can-ozcan/Setup-for-Testing-Optical-Chips/Setup 2/Setup 2.jpg

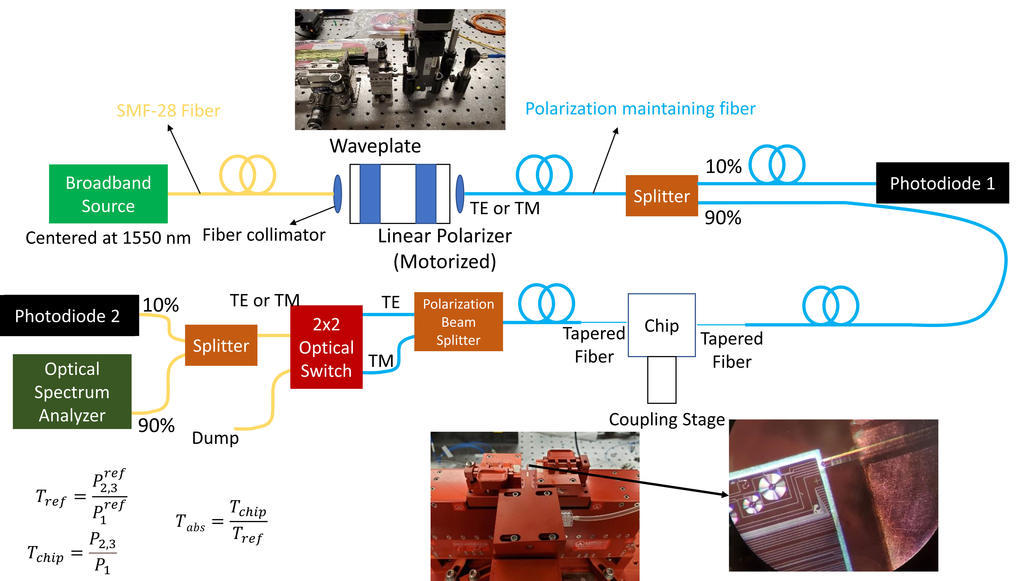
Setup 2/Setup 2.jpg
