can-ozcan/Setup-for-Testing-Optical-Chips/Setup 1/Setup 1.jpg

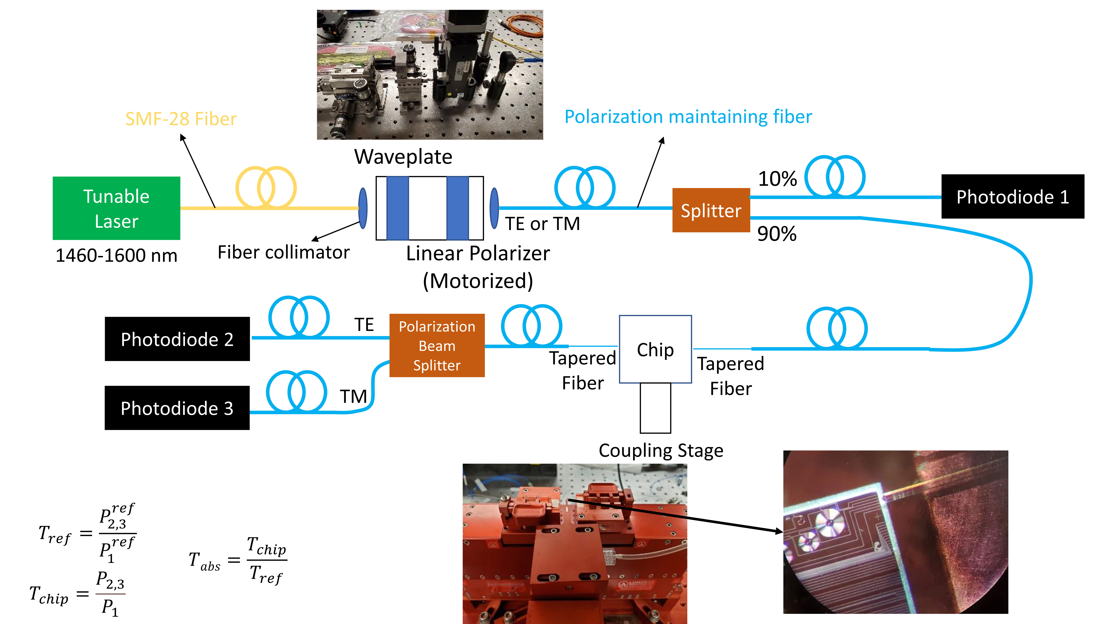
Setup 1/Setup 1.jpg
