can-ozcan/Setup-for-Testing-Optical-Chips/Setup 1/Misalignment.jpg

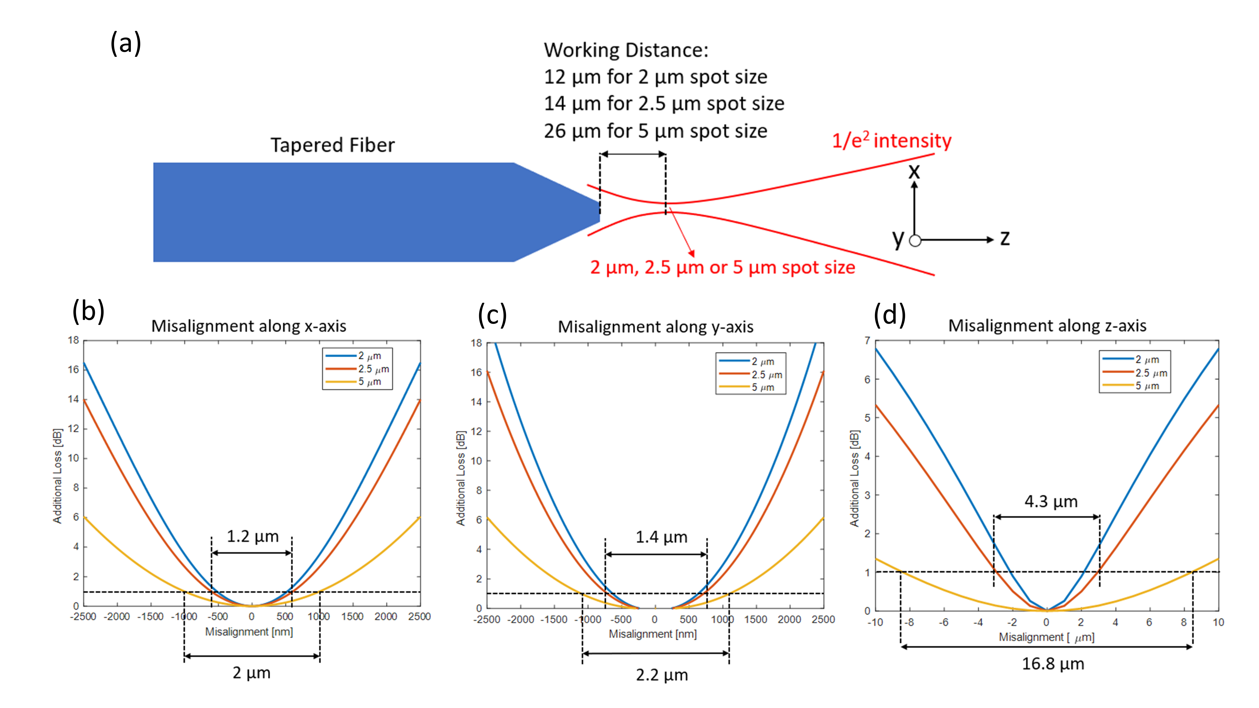
Setup 1/Misalignment.jpg
