can-ozcan/Setup-for-Testing-Optical-Chips/Setup 1/Setup 1 workflow.png

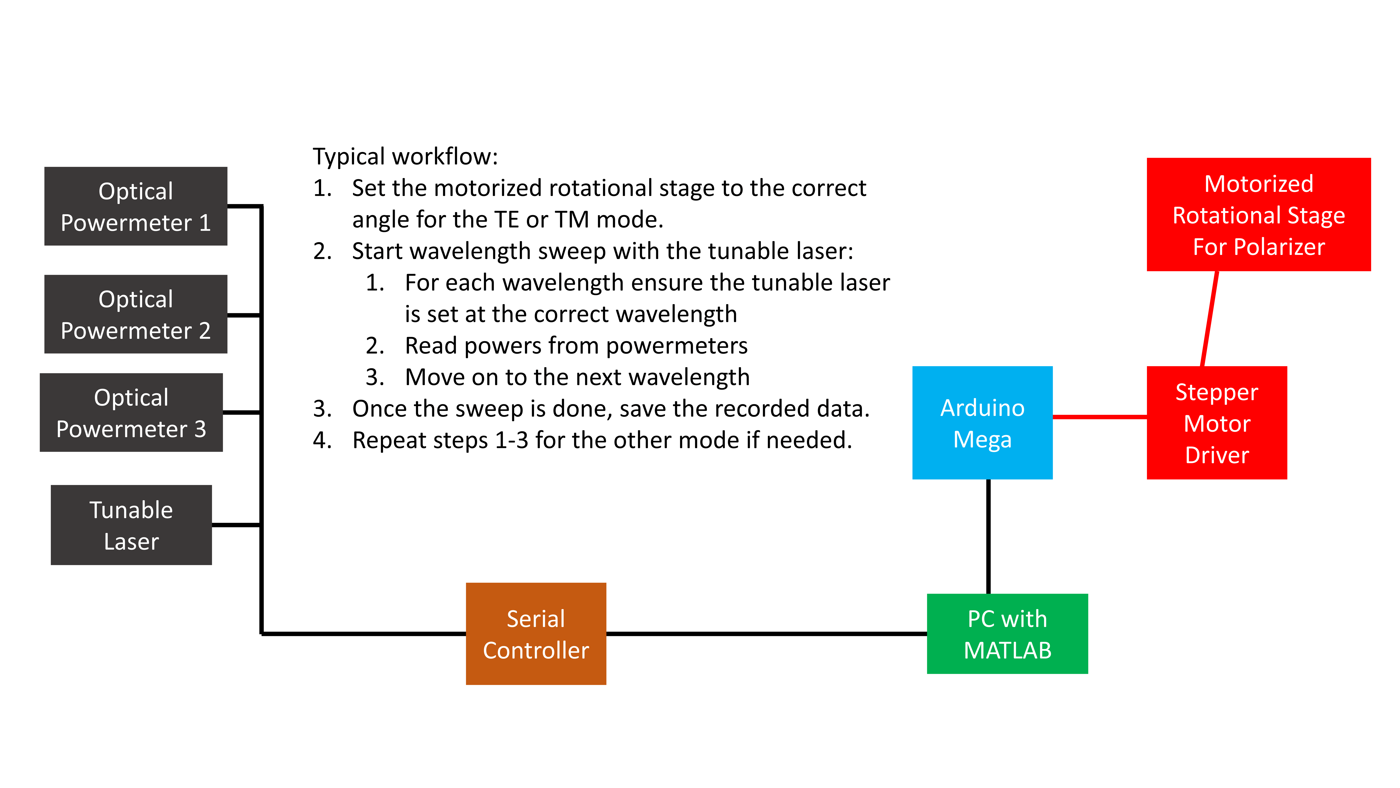
Setup 1/Setup 1 workflow.png
